glocklueng/flyport-wifi-rc-car/Client_Android/WiFiRCCar/ic_launcher-web.png

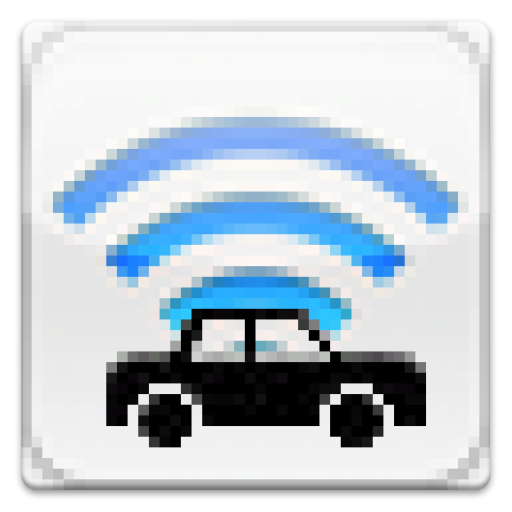
Client_Android/WiFiRCCar/ic_launcher-web.png
