glocklueng/flyport-wifi-rc-car/Images/ElectronicsFail.jpg

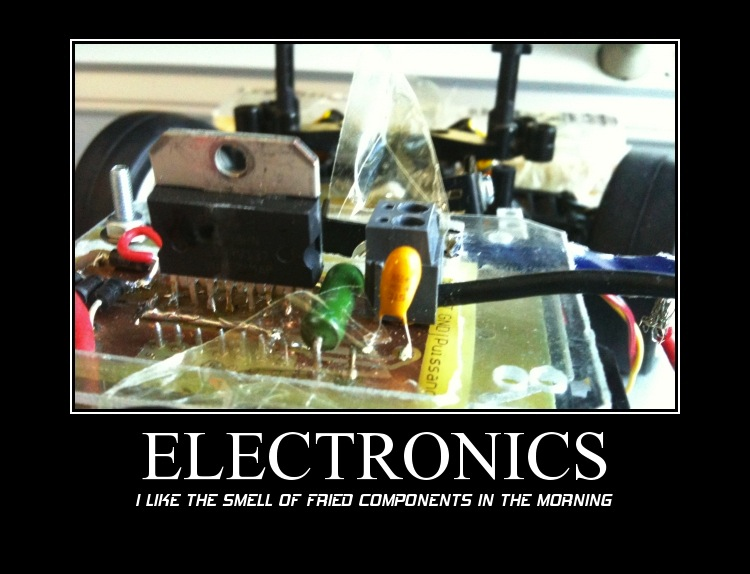
Images/ElectronicsFail.jpg
