glocklueng/flyport-wifi-rc-car/Images/screen1.jpg

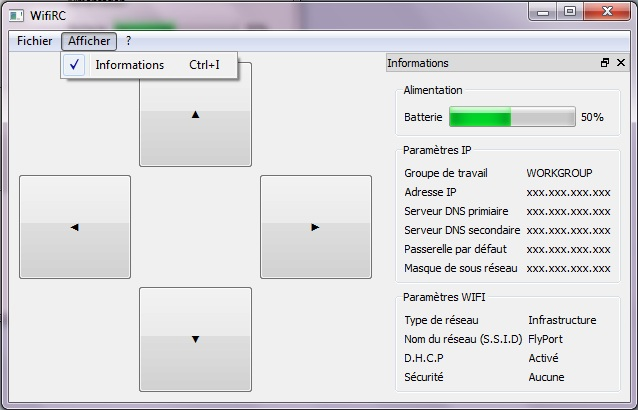
Images/screen1.jpg
