glocklueng/flyport-wifi-rc-car/Images/screen2.jpg

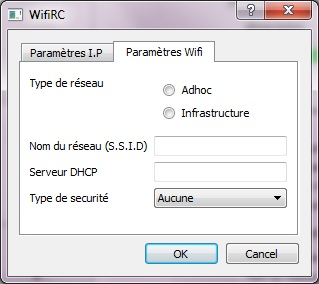
Images/screen2.jpg
