glocklueng/flyport-wifi-rc-car/Images/WBS/WBS1.png

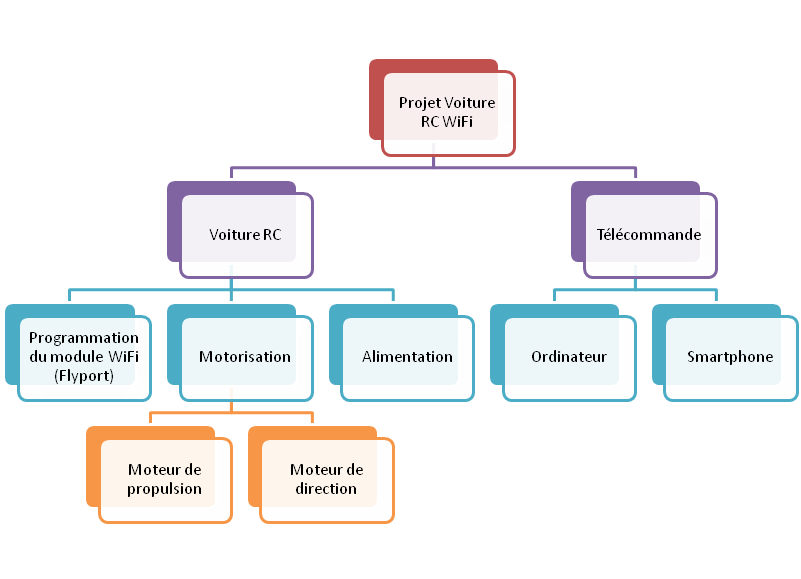
Images/WBS/WBS1.png
