glocklueng/flyport-wifi-rc-car/Images/WBS/WBS3D.png

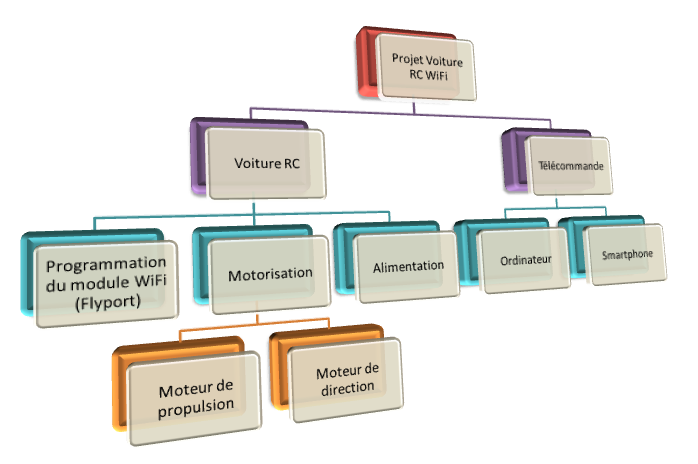
Images/WBS/WBS3D.png
