glocklueng/flyport-wifi-rc-car/Images/WBS/WBS4.png

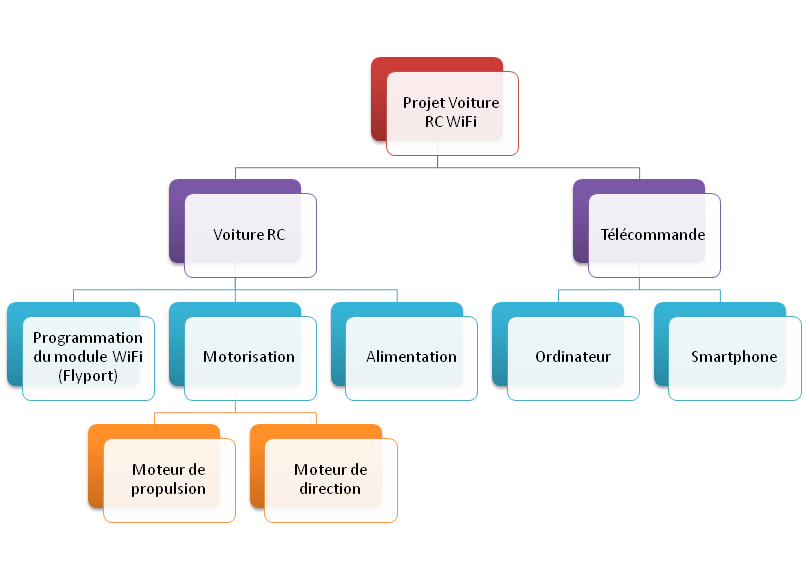
Images/WBS/WBS4.png
