glocklueng/flyport-wifi-rc-car/Wifi-rc-Altium/regu/regu.png

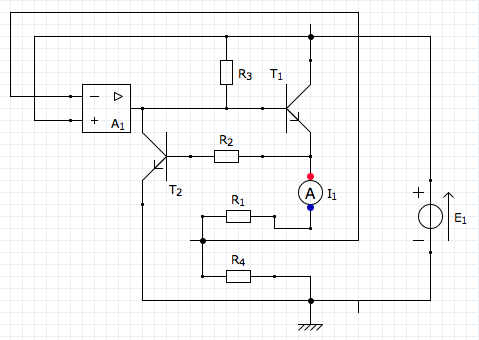
Wifi-rc-Altium/regu/regu.png
