glocklueng/flyport-wifi-rc-car/Wifi-rc-Altium/Puissance/carte_puissance.pdf

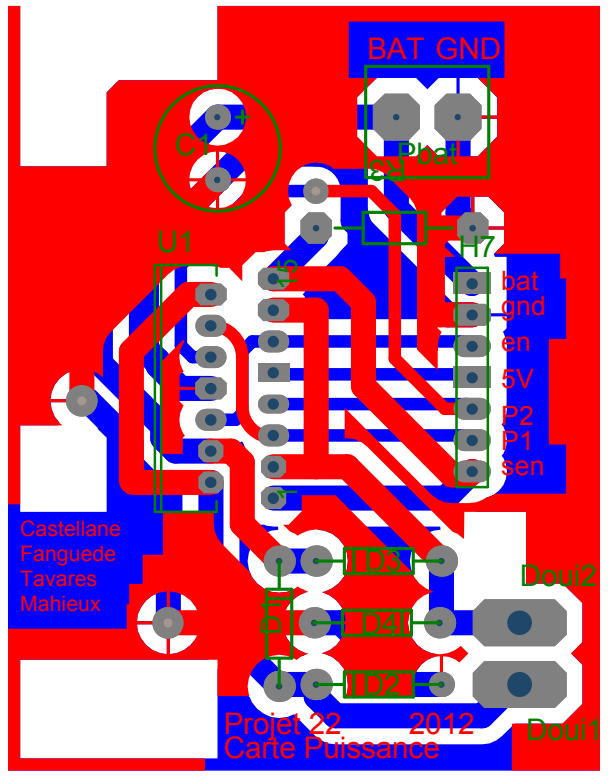
[picture p31: page 1]
