glocklueng/flyport-wifi-rc-car/(list of files, drawings)

Other design files:
22_projet_groupe_partie_puissance_amelioree_VNH3SP30.PcbDoc
Puissance_puissante/multipowerso-30.pcblib
Puissance_puissante/PCB puissant.PcbDoc
Puissance_puissante/puissance_puissante.PrjPCB
Puissance_puissante/schema.SchDoc
Puissance_puissante/VNH3SP30-E.SchLib
Wifi-rc-Altium/MainBoard/MainBoard.PrjPcb
Wifi-rc-Altium/MainBoard/MainBoard_PCB.PcbDoc
Wifi-rc-Altium/MainBoard/MainBoard_PCB_spaced.PcbDoc
Wifi-rc-Altium/MainBoard/MainBoard_Schematic.SchDoc
Wifi-rc-Altium/PontenH/L298-guillaume.SchDoc
Wifi-rc-Altium/PontenH/L298.SchDoc
Wifi-rc-Altium/PontenH/L298.~(1).SchDoc
Wifi-rc-Altium/PontenH/L298.~(2).SchDoc
Wifi-rc-Altium/PontenH/L298.~(3).SchDoc
Wifi-rc-Altium/PontenH/L298.~(4).SchDoc
Wifi-rc-Altium/PontenH/L298.~(5).SchDoc
Wifi-rc-Altium/PontenH/PCB22-guillaume.PcbDoc
Wifi-rc-Altium/PontenH/PCB22.~(3).PcbDoc
Wifi-rc-Altium/PontenH/PonEnH.~(1).PcbDoc
Wifi-rc-Altium/PontenH/PonEnH.~(2).PcbDoc
Wifi-rc-Altium/PontenH/PonEnH.~(5).PcbDoc
Wifi-rc-Altium/PontenH/PontenH.PrjPcb
Wifi-rc-Altium/PontenH/PontenH.~(1).PrjPcb
Wifi-rc-Altium/PontenH/PontenH.~(2).PrjPcb
Wifi-rc-Altium/PontenH/PontenH.~(3).PrjPcb
Wifi-rc-Altium/Puissance/carte_puissance.PcbDoc
Wifi-rc-Altium/Puissance/L298.SchDoc
Wifi-rc-Altium/Puissance/puisance.PrjPcb
Wifi-rc-Altium/regu/regu.SchDoc
Wifi-rc-Altium/regu/regu.~(1).SchDoc
