glocklueng/flyport-wifi-rc-car/(commit log)

2012-02-06 organisation dossiers 2 : déplacement de socket.c vers trunk
2012-02-09 protocole de communication
2012-02-14 Création d'un dossier image et up de quelques screens et goodies
2012-02-17 UpLoad du début du rapport de reformulation pour Matthieu
2012-02-18 projet altium : régulation courant
    [PCB_wifi-rc.PrjPcb, PCB_wifi-rc.sdf, PCB_wifi-rc.~(1).PrjPcb, PCB_wifi-rc.~(1).sdf, regu.SchDoc, regu.~(1).SchDoc]
2012-03-09 atlium PCB L298 + limiteur courant
    [L298.SchDoc, L298.~(1).SchDoc, L298.~(2).SchDoc, L298.~(3).SchDoc, L298.~(4).SchDoc, L298.~(5).SchDoc, PCB_wifi-rc.~(1).sdf, PonEnH.PcbDoc]
2012-03-14 suppression fichiers inutiles
    [PCB_wifi-rc.PrjPcb, PCB_wifi-rc.sdf, PCB_wifi-rc.~(1).PrjPcb, regu.SchDoc, regu.~(1).SchDoc]
2012-03-28 fichier manquant
    [PCB22.PcbDoc, PCB22.~(3).PcbDoc, PonEnH.~(5).PcbDoc]
2012-03-30 Update début séance vendredi 30/03
    [L298.SchDoc, PCB22.PcbDoc]
2012-04-05 Added MainBoard folder/project in Altium.
    [MainBoard.PrjPcb, MainBoard_PCB.PcbDoc, MainBoard_Schematic.SchDoc]
2012-04-06 Added Rapport de Reformulation
2012-04-06 l298 board
    [L298.SchDoc, carte_puissance.PcbDoc, puisance.PrjPcb]
2012-04-07 Routage MainBoard terminé.
    [MainBoard_PCB.PcbDoc, MainBoard_Schematic.SchDoc]
2012-04-07 done 2
    [L298.SchDoc, carte_puissance.PcbDoc]
2012-04-08 MainBoard update.
    [MainBoard.PrjPcb, MainBoard_PCB.PcbDoc, MainBoard_Schematic.SchDoc]
2012-04-14 Mise à jour MainBoard (calque Flyport et carte de Puissance)
    [MainBoard.PrjPcb, MainBoard_PCB.PcbDoc, MainBoard_Schematic.SchDoc]
2012-04-17 Fin PCB MainBoard
    [MainBoard_PCB.PcbDoc]
2012-04-17 Final release with pony add-on.
    [MainBoard_PCB.PcbDoc, carte_puissance.PcbDoc]
2012-04-27 projet info
    [graphe1_2012.csv, metro2012.csv]
2012-04-27 debut de code de astar
2012-04-30 Rebelote de la partie puissance, cette fois avec la puissance d'un vrai pont en H.
    [PCB puissant.PcbDoc, VNH3SP30-E.SchLib, multipowerso-30.pcblib, puissance_puissante.PrjPCB, schema.SchDoc]
2012-05-01 astar suite ... l'erreur de seg fault provient certainement de removeData
2012-05-03 partie puissance
    [L298.SchDoc, carte_puissance.PcbDoc]
2012-05-04 partie puissance qui est trop puissante
    [MainBoard_PCB.PcbDoc, carte_puissance.PcbDoc, puisance.PrjPcb]
2012-05-05 Mainboard 2 RC1
    [MainBoard_Schematic.SchDoc]
2012-05-05 MainBoard 2 RC2
    [MainBoard.PrjPcb, MainBoard_PCB.PcbDoc]
2012-05-07 astar MARCHE !! to do : recherche par nom de station liste triées SDL
2012-05-07 espacement mainboard pour vis
    [MainBoard.PrjPcb]
2012-05-07 Avec la mainboard à jour, c'est mieux...
    [MainBoard_PCB_spaced.PcbDoc]
2012-05-07 MainBoard 2 (spaced) update.
    [MainBoard_PCB_spaced.PcbDoc]
2012-05-08 recherche par nom, tabulation dans fichier.c, structure ListeRes o=pou le stcokage des données finale todo : gerer les correspondance notamment à l'arrivée et au depart
2012-05-08 MainBoard 2 update.
    [MainBoard_PCB_spaced.PcbDoc]
2012-05-08 update MainBoard
    [MainBoard_PCB_spaced.PcbDoc]
2012-05-15 révision partie puissance composant de surface
    [PCB puissant.PcbDoc, VNH3SP30-E.SchLib, multipowerso-30.pcblib, puissance_puissante.PrjPCB, schema.SchDoc]
2012-06-02 - Correction de queslques fautes d'accord Temps estimée.\nAmélioration légère du design de la page
2012-06-02 Supression des listes dans le main. Test fuites mémoire avec ton programme requis
2012-06-02 temps en min + commentage de 2 lignes de printf inutile
2012-06-02 Free de tous les LOAD_IMG dans la boucle while xD
2012-06-02 init a null des arcs
2012-06-02 Ajout d'en tête sur tous les fichiers
