glocklueng/flyport-wifi-rc-car/(notices)

Notices in the files:
Flyport/dev_adhoc/HTTPApp.c:
This is free software; you can redistribute it and/or modify it under
the terms of the GNU General Public License (version 2) as published by
the Free Software Foundation AND MODIFIED BY OpenPicus team.
***NOTE*** The exception to the GPL is included to allow you to distribute
